poucz/picoTemperature/doc/IMG_20240620_114536.jpg

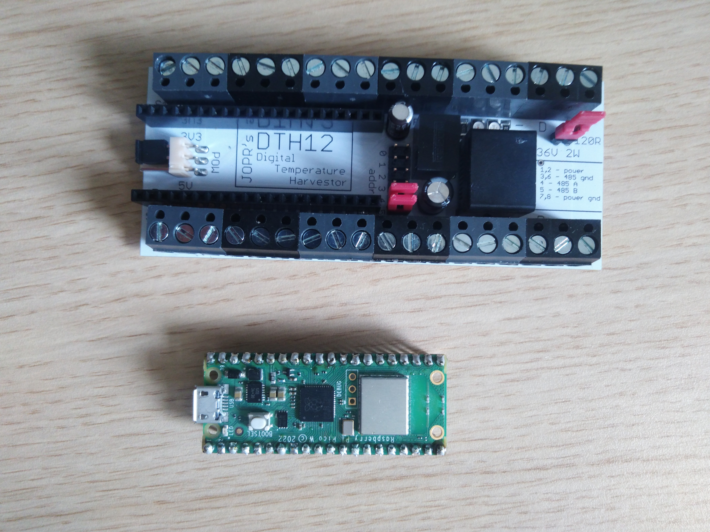
doc/IMG_20240620_114536.jpg
