poucz/picoTemperature/doc/IMG_20240620_114542.jpg

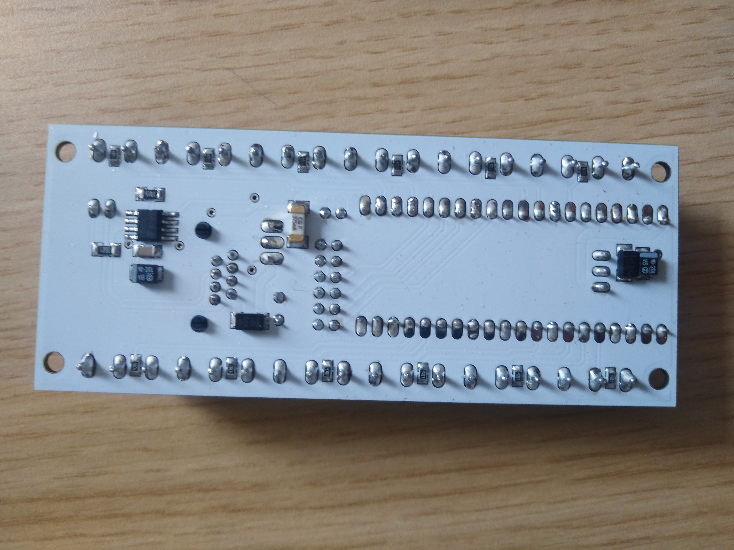
doc/IMG_20240620_114542.jpg
