poucz/picoTemperature/doc/IMG_20240620_114550.jpg

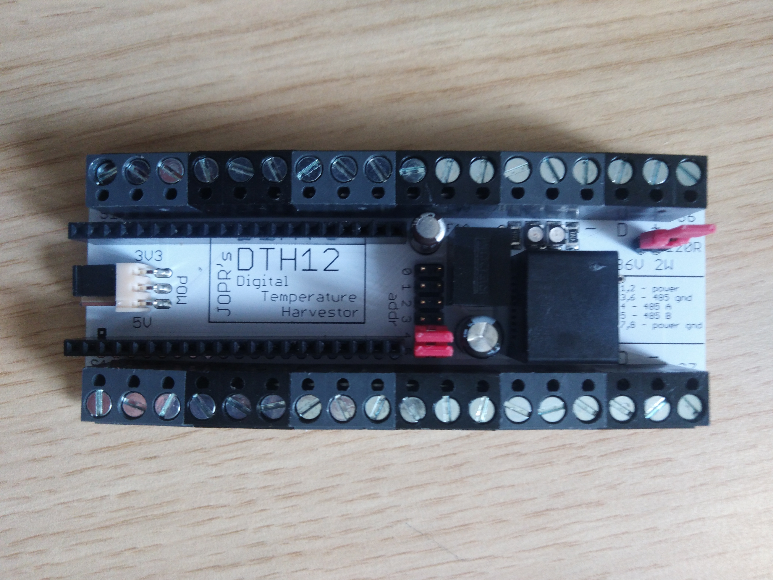
doc/IMG_20240620_114550.jpg
