poucz/picoTemperature/doc/IMG_20240620_140256.jpg

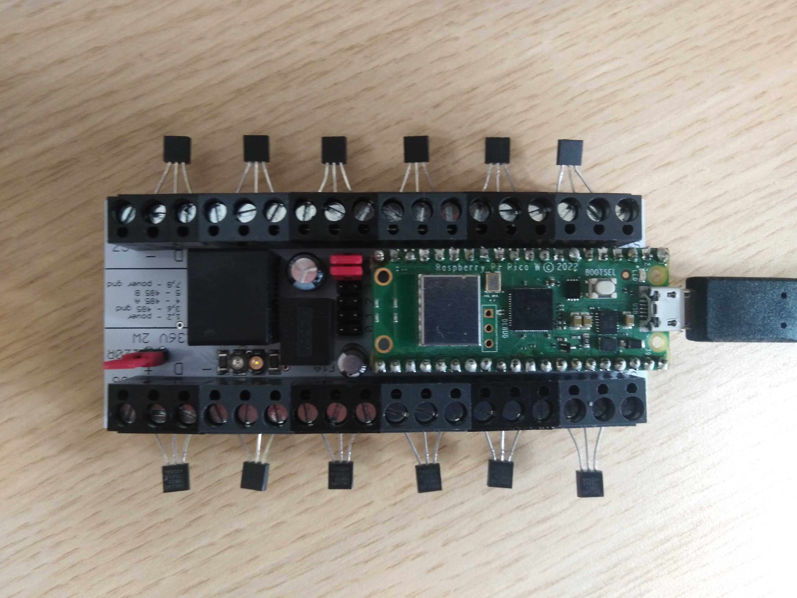
doc/IMG_20240620_140256.jpg
