poucz/picoTemperature/doc/teplomer.pdf

# SENSORS

GND | GND | GND | GND | GND | GND GND | GND | GND | GND | GND | GND

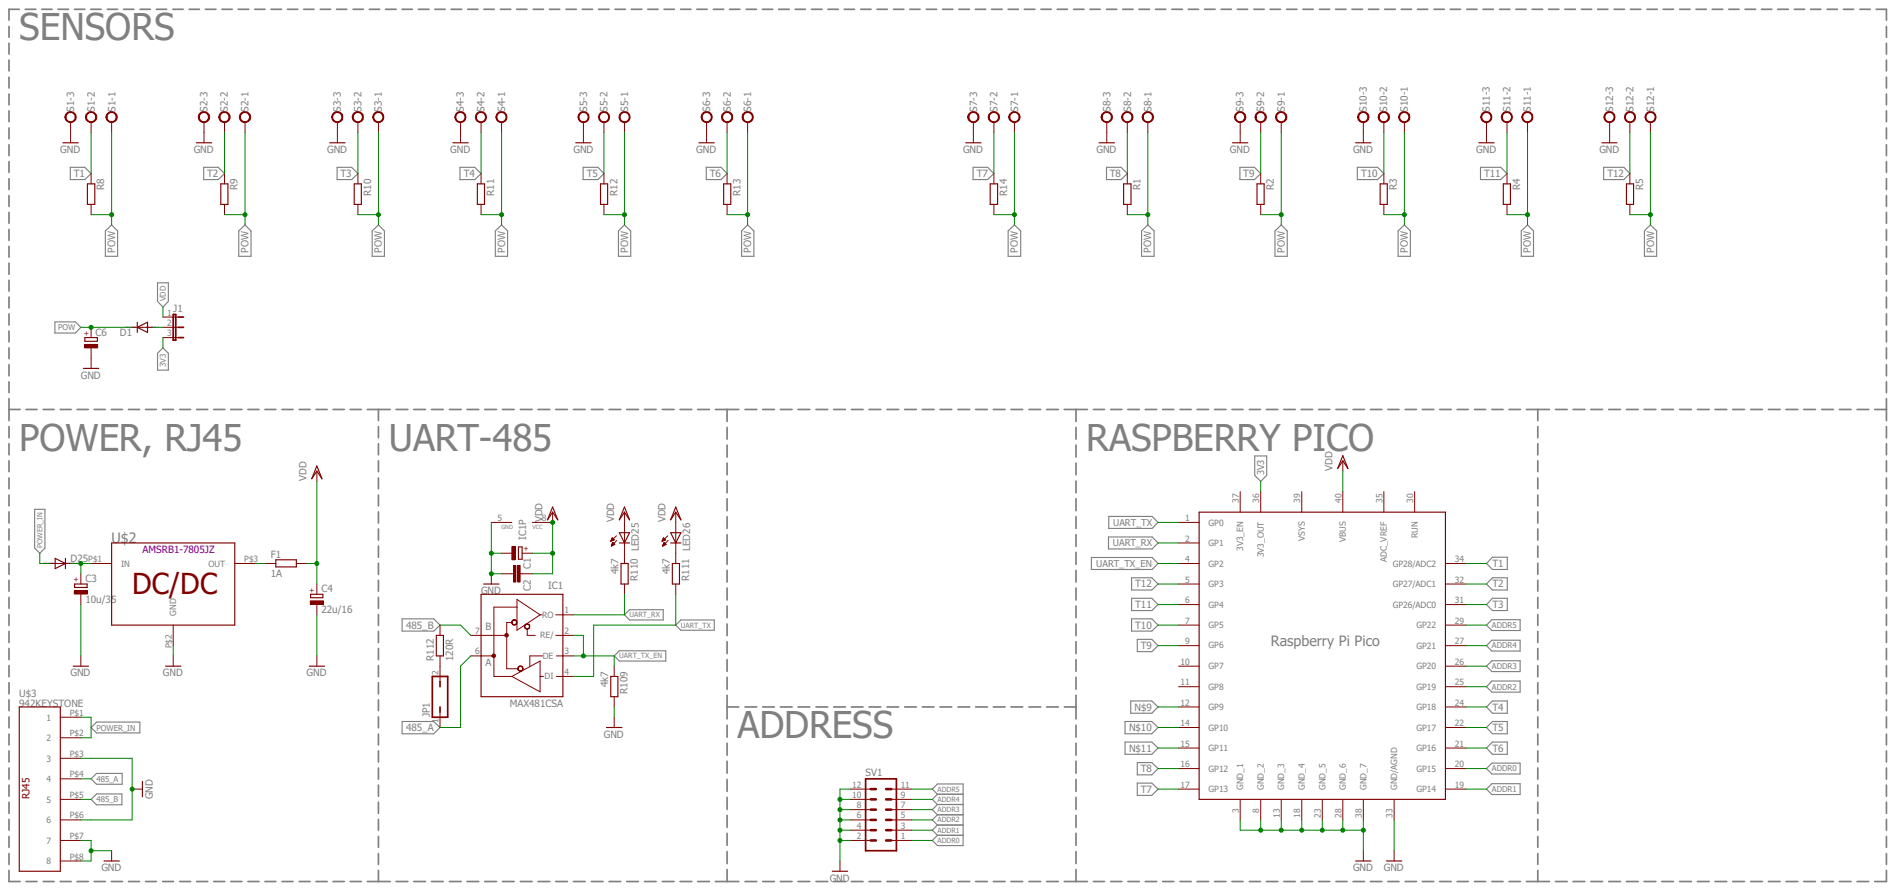
[picture p6: page 1]
