poucz/picoTemperature/doc/teplomer.sch

## EAGLE design doc/teplomer.sch (2024-11-09)

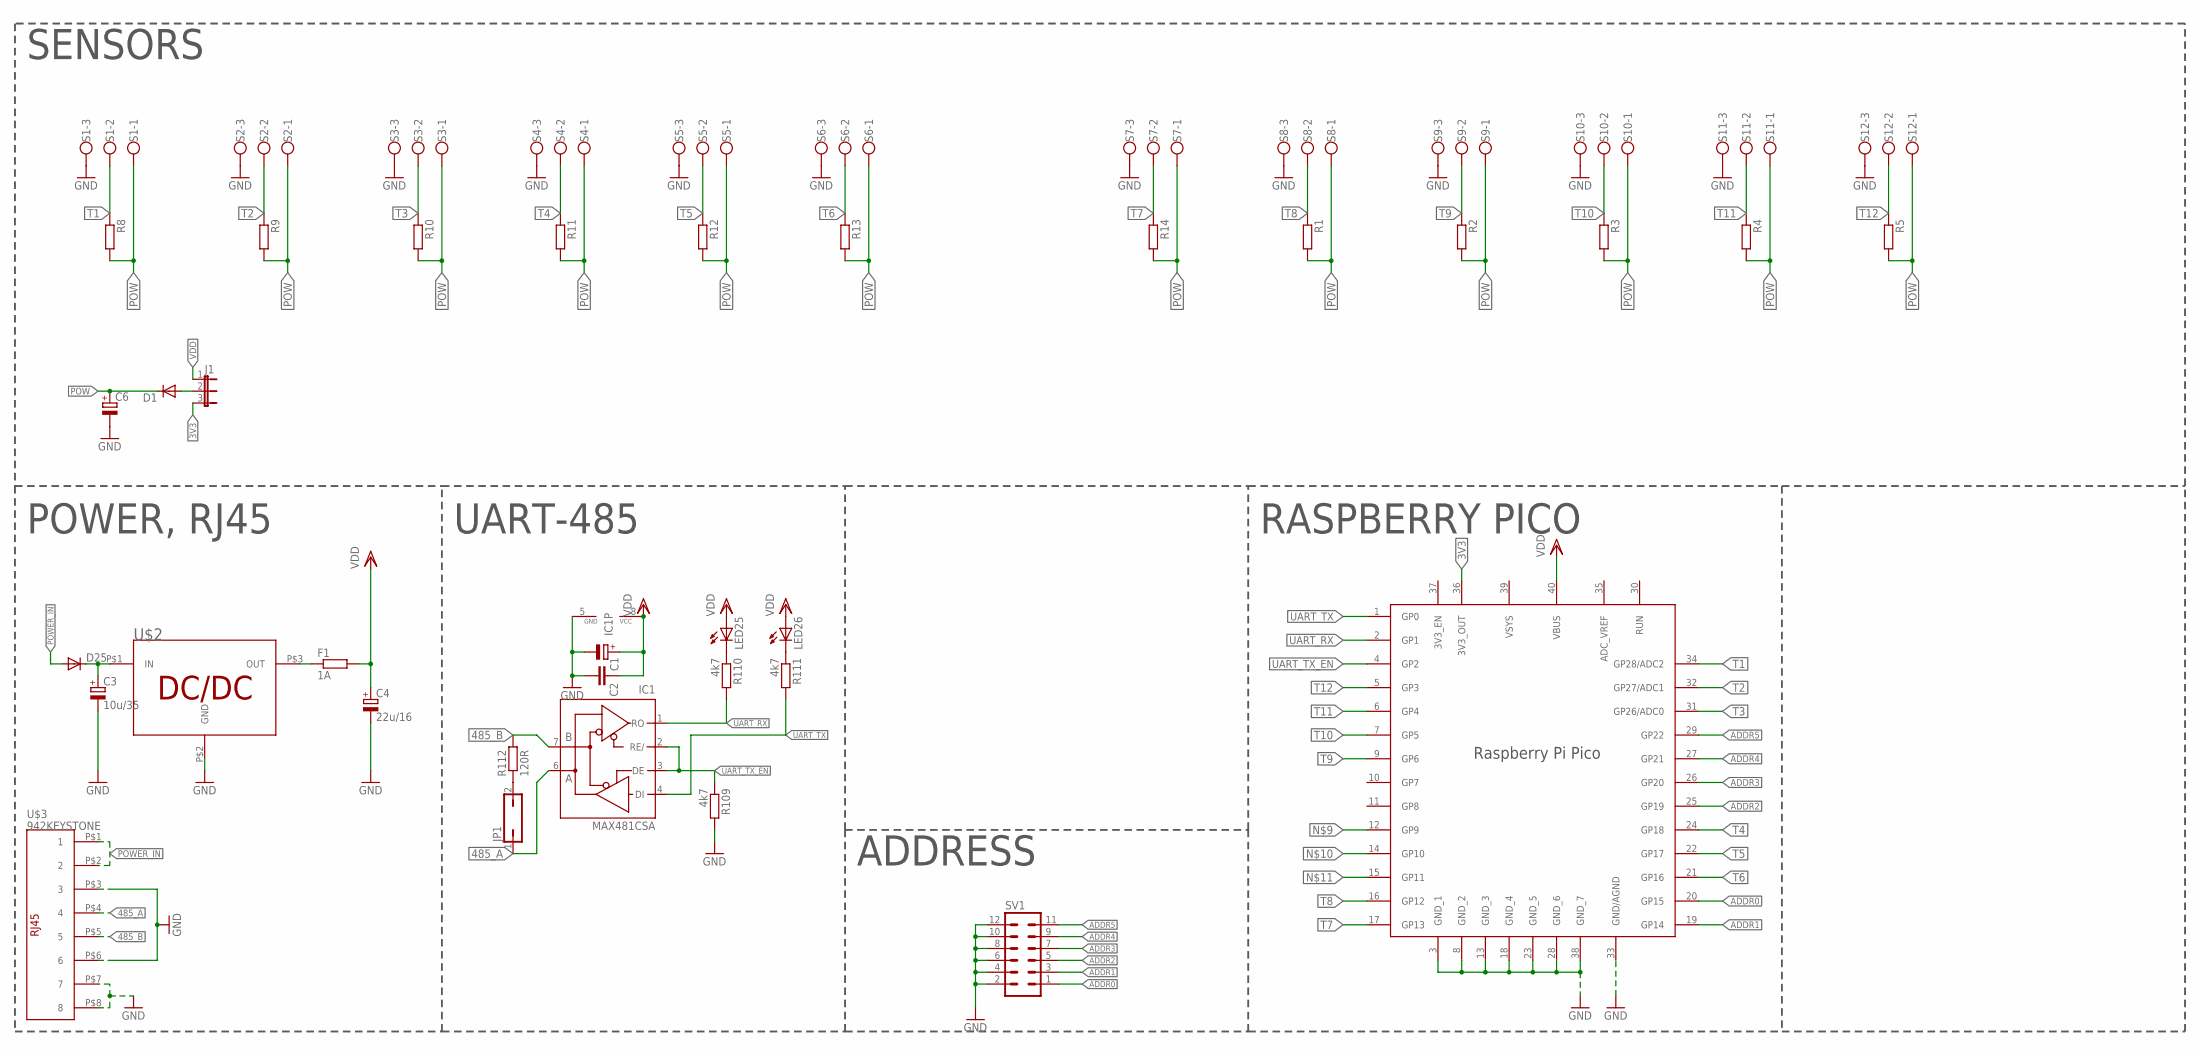
[picture p7: schematic teplomer.sch]

Parts:
C1, C6: CPOL-EUCT3528; CT3528
C2: C-EUC1206; C1206
C3: 10u/35; E3,5-8
C4: 22u/16; E2,5-7
D1, D25: DIODE-DO-214AC; DO-214AC
F1: 1A; R2512
IC1: MAX481CSA; SO08
J1: JP2W
JP1: JP1Q; JP1
LED25, LED26: LEDKA-3528ASYC; KA-3528ASYC
R1, R2, R3, R4, R5, R8, R9, R10, R11, R12, R13, R14: R-EU_R0805; R0805
R109, R110, R111: 4k7; M1206
R112: 120R; M1206
S1, S2, S3, S4, S5, S6, S7, S8, S9, S10, S11, S12: W237-103
SV1: MA06-2
U$1: RASPBERRY_PI_PICO
U$2: AIMTEC
U$3: 942KEYSTONE; RJ45

Connections:
3V3: J1.3, U$1.36 (3V3_OUT)
485_A: IC1.6 (A), JP1.1, U$3.P$4 (4)
485_B: IC1.7 (B), R112.2, U$3.P$5 (5)
ADDR0: SV1.1, U$1.20 (GP15)
ADDR1: SV1.3, U$1.19 (GP14)
ADDR2: SV1.5, U$1.25 (GP19)
ADDR3: SV1.7, U$1.26 (GP20)
ADDR4: SV1.9, U$1.27 (GP21)
ADDR5: SV1.11, U$1.29 (GP22)
GND: C1.-, C2.2, C3.-, C4.-, C6.-, IC1.5 (GND), R109.2, S1.3, S2.3, S3.3, S4.3, S5.3, S6.3, S7.3, S8.3, S9.3, S10.3, S11.3, S12.3, SV1.2, SV1.4, SV1.6, SV1.8, SV1.10, SV1.12, U$1.3 (GND_1), U$1.8 (GND_2), U$1.13 (GND_3), U$1.18 (GND_4), U$1.23 (GND_5), U$1.28 (GND_6), U$1.33 (GND/AGND), U$1.38 (GND_7), U$2.P$2 (GND), U$3.P$3 (3), U$3.P$7 (7), U$3.P$8 (8)
unnamed: C3.+, D25.C, U$2.P$1 (IN)
unnamed: D1.A, J1.2
unnamed: LED25.C, R110.1
unnamed: LED26.C, R111.1
unnamed: F1.1, U$2.P$3 (OUT)
unnamed: JP1.2, R112.1
POW: C6.+, D1.C, R1.2, R2.2, R3.2, R4.2, R5.2, R8.2, R9.2, R10.2, R11.2, R12.2, R13.2, R14.2, S1.1, S2.1, S3.1, S4.1, S5.1, S6.1, S7.1, S8.1, S9.1, S10.1, S11.1, S12.1
POWER_IN: D25.A, U$3.P$1 (1), U$3.P$2 (2)
T1: R8.1, S1.2, U$1.34 (GP28/ADC2)
T2: R9.1, S2.2, U$1.32 (GP27/ADC1)
T3: R10.1, S3.2, U$1.31 (GP26/ADC0)
T4: R11.1, S4.2, U$1.24 (GP18)
T5: R12.1, S5.2, U$1.22 (GP17)
T6: R13.1, S6.2, U$1.21 (GP16)
T7: R14.1, S7.2, U$1.17 (GP13)
T8: R1.1, S8.2, U$1.16 (GP12)
T9: R2.1, S9.2, U$1.9 (GP6)
T10: R3.1, S10.2, U$1.7 (GP5)
T11: R4.1, S11.2, U$1.6 (GP4)
T12: R5.1, S12.2, U$1.5 (GP3)
UART_RX: IC1.1 (RO), R110.2, U$1.2 (GP1)
UART_TX: IC1.4 (DI), R111.2, U$1.1 (GP0)
UART_TX_EN: IC1.2 (RE/), IC1.3 (DE), R109.1, U$1.4 (GP2)
VDD: C1.+, C2.1, C4.+, F1.2, IC1.8 (VCC), J1.1, LED25.A, LED26.A, U$1.40 (VBUS)

Notes on the sheet:
SENSORS
POWER, RJ45
UART-485
ADDRESS
RASPBERRY PICO
