poucz/picoTemperature/(commit log)

2024-11-09 Pico W
    [teplomer.sch]
2025-02-23 bug - reference na objkt ktery jsem znicil pop()
    [main_wifi.cpp]
